dangtbh1623/SmartHomeEnocean/README.md

# SmartHomeEnocean
Projekt, um ein SmartHome-System mit EnOcean und MQTT aufzubauen.
#

Dang Trinh.
#
Christopher Hobert.
#
