dangtbh1623/SmartHomeEnocean/Schematic/Pinbelegung.xlsx

ESP32 |  | TH02 |  |  | ESP32 |  | TCM 320
Signalname | Pin | Pin | Signalname | Note | Signalname | Pin | Pin | Signalname | Note
GND | J2_19 | 1 | GND |  | GND | J3_19 | 1 | GND
VDD33 | J2_20 | 2 | VCC |  | VDD33 | J3_18 | 15 | VDD
IO21 | J2_4 | 3 | SDA | I2C Serial Data | IO15 | J3_14 | 7 | ADIO6 | UART input
IO22 | J2_5 | 4 | SCL | I2C Serial Clock | IO14 | J3_11 | 8 | ADIO7 | UART output
ESP32 |  | RGB_Led
Signalname | Pin | Pin | Signalname
EXT_5V | J3_20 | 1 | VCC
IO18 | J2_8 | 2 | R
IO10 | J2_10 | 3 | G
IO19 | J2_6 | 4 | B
