dangtbh1623/SmartHomeEnocean/(commit log)

2020-12-31 Activitaet Diagramm hinzufuegen
    [Pinbelegung.xlsx]
2021-01-03 Temperatur added
